LaskaKit/ESPink-Frame-7x/Version.md

### Version 1.2
- added test pads
- SPECTRA driver changes:
    - C20: 4.7uF -> 10uF
    - C13: 4.7uF -> 10uF
    - C47: 47uF -> 100uF 
    - R35: 0.24 ohm -> 0.1ohm
    - Q4: Si1308EDL -> AO3400A
#### Version 1.1
- Spectra connector mirrored
- Window for WiFi antenna
- Display jumper added
#### Version 1.0
- Initial | Počáteční
