LaskaKit/ESPink-Frame-7x/img/LaskaKit-espink-frame-7-x-e-paper-board-5.jpg

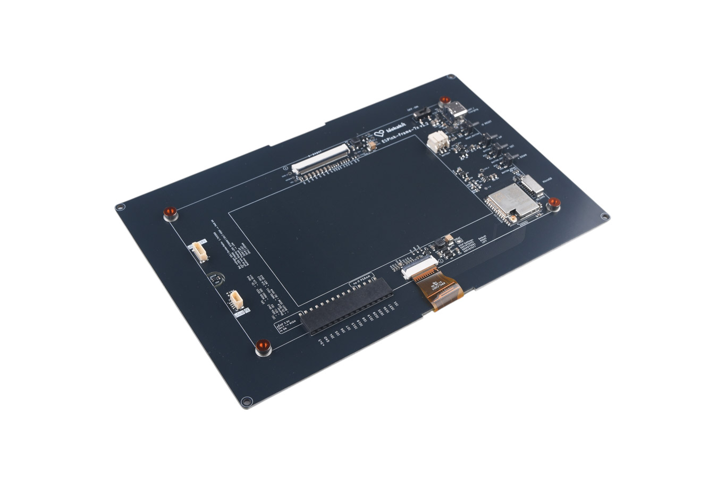
img/LaskaKit-espink-frame-7-x-e-paper-board-5.jpg
