LaskaKit/ESPink-Frame-7x/img/laskakit-live-7-x-pro-e-paper-stavebnice-s-wifi-pro---zivy-obraz-5.jpg

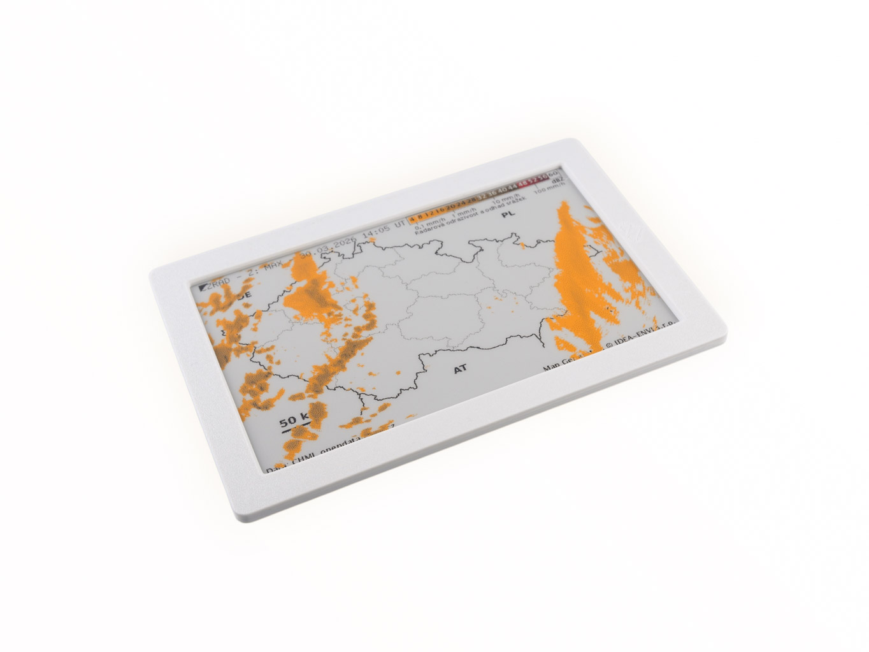
img/laskakit-live-7-x-pro-e-paper-stavebnice-s-wifi-pro---zivy-obraz-5.jpg
