LaskaKit/ESPink-Frame-7x/3D/all_live-75-pro.3mf

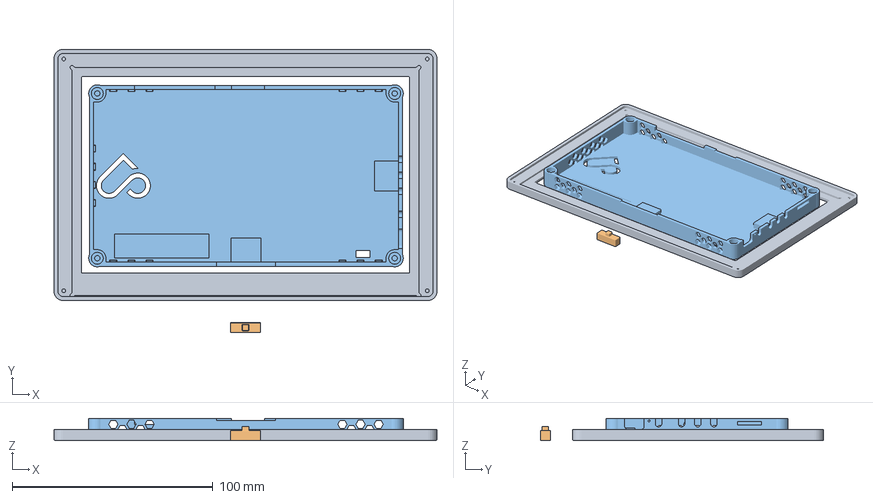
[picture p17: CAD file, 2026-03-31, last stored version]
3D/all_live-75-pro.3mf
190.6 x 141.0 x 11.0 mm
Printed_face v6
Switch v5
back v49
