LaskaKit/ESPink-Frame-7x/HW/ESPink-Frame-7x_v1_2.pdf

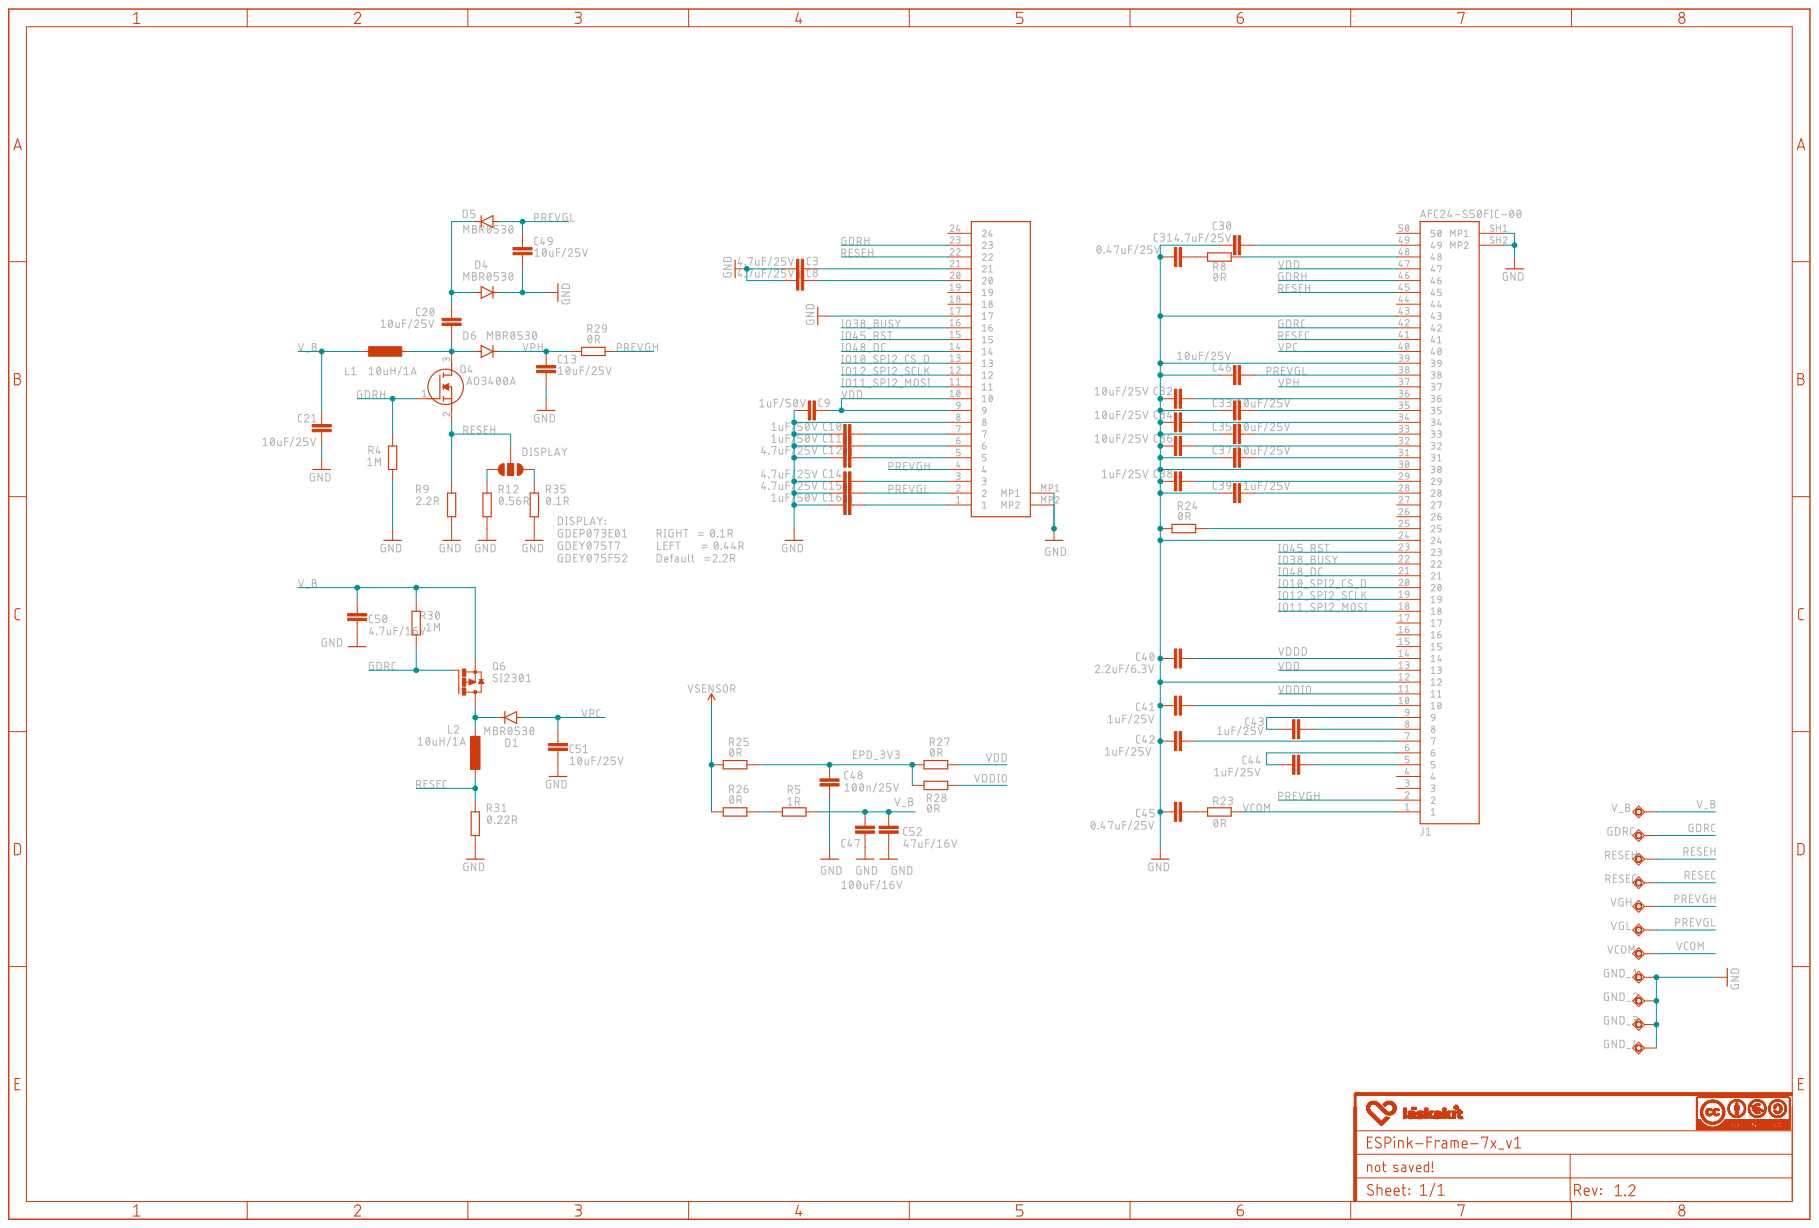
[picture p18: page 1]

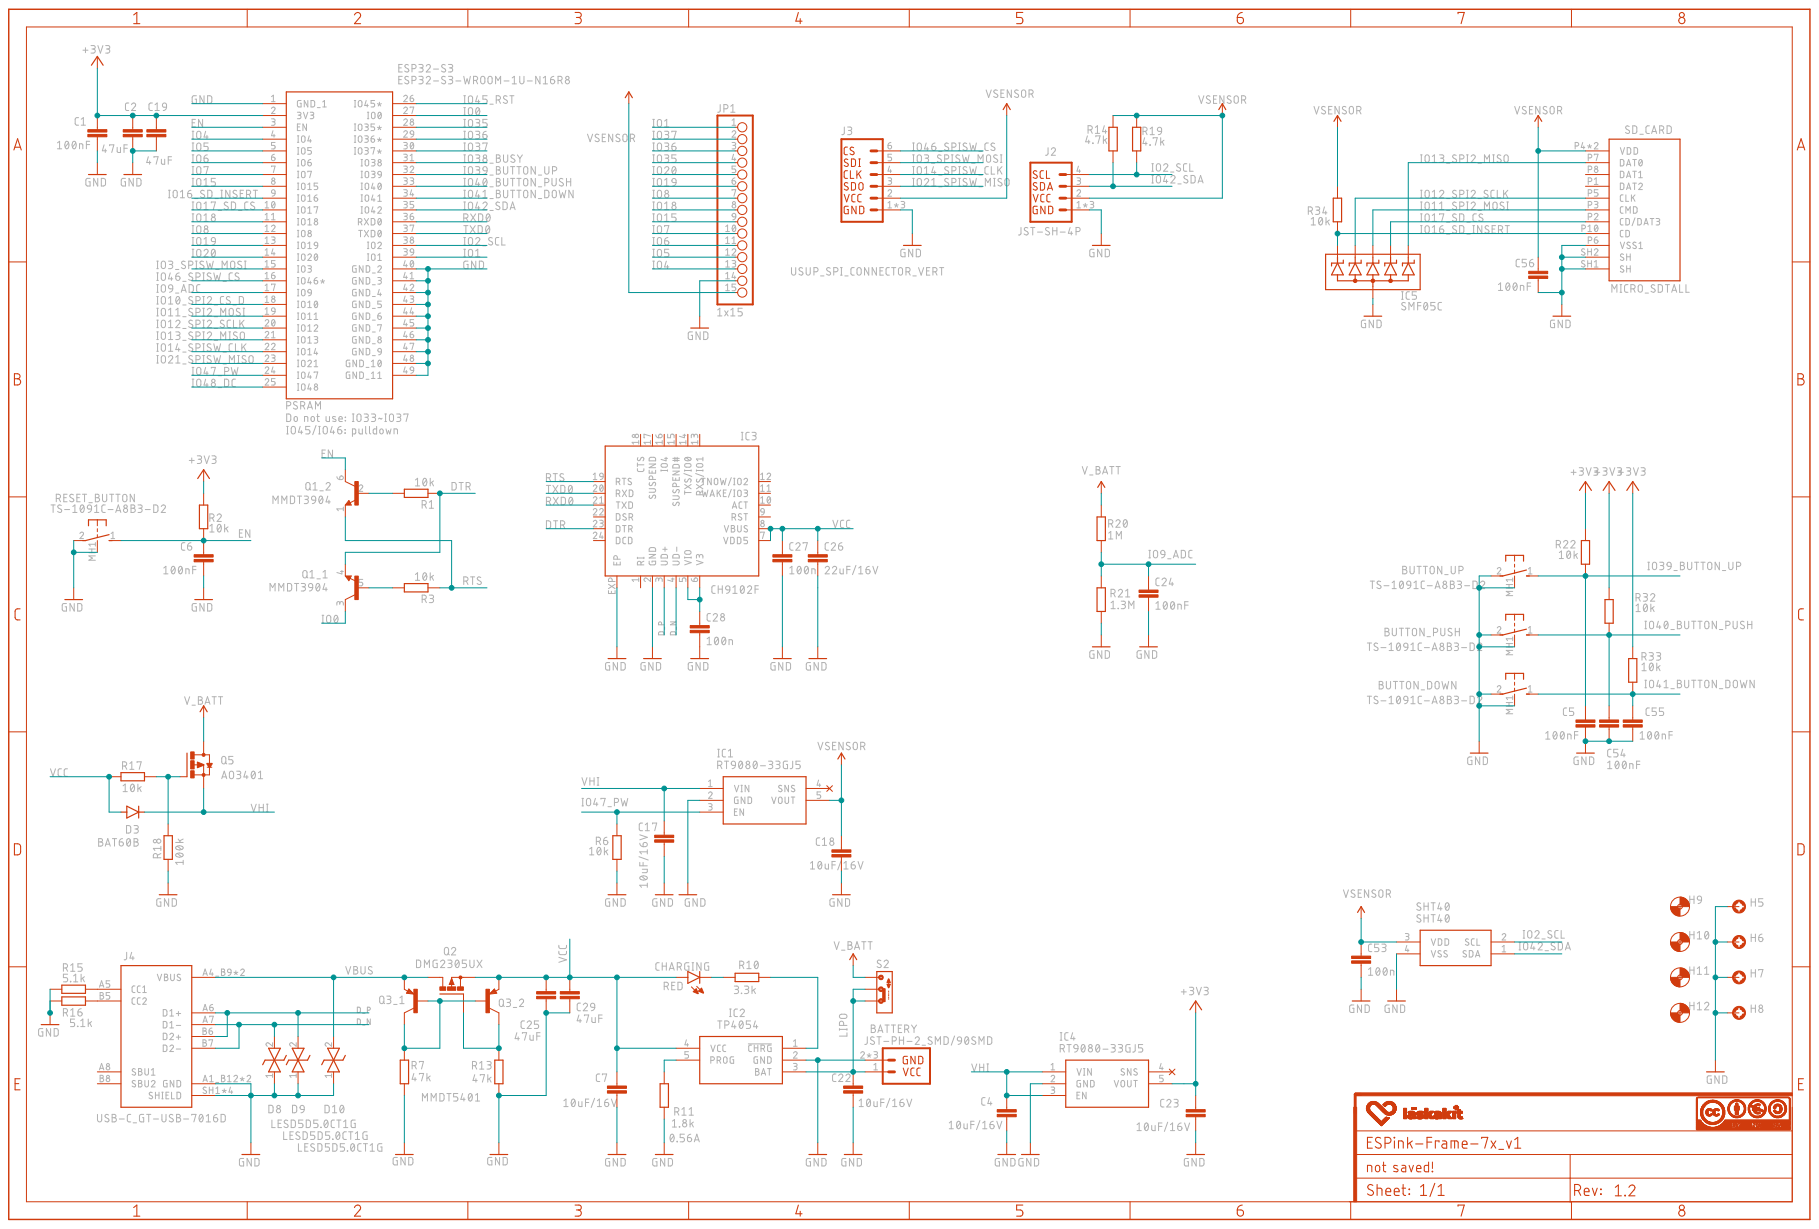
[picture p19: page 2]
