LaskaKit/ESPink-Frame-7x/HW/ESPink-Frame-7x_v1.pdf

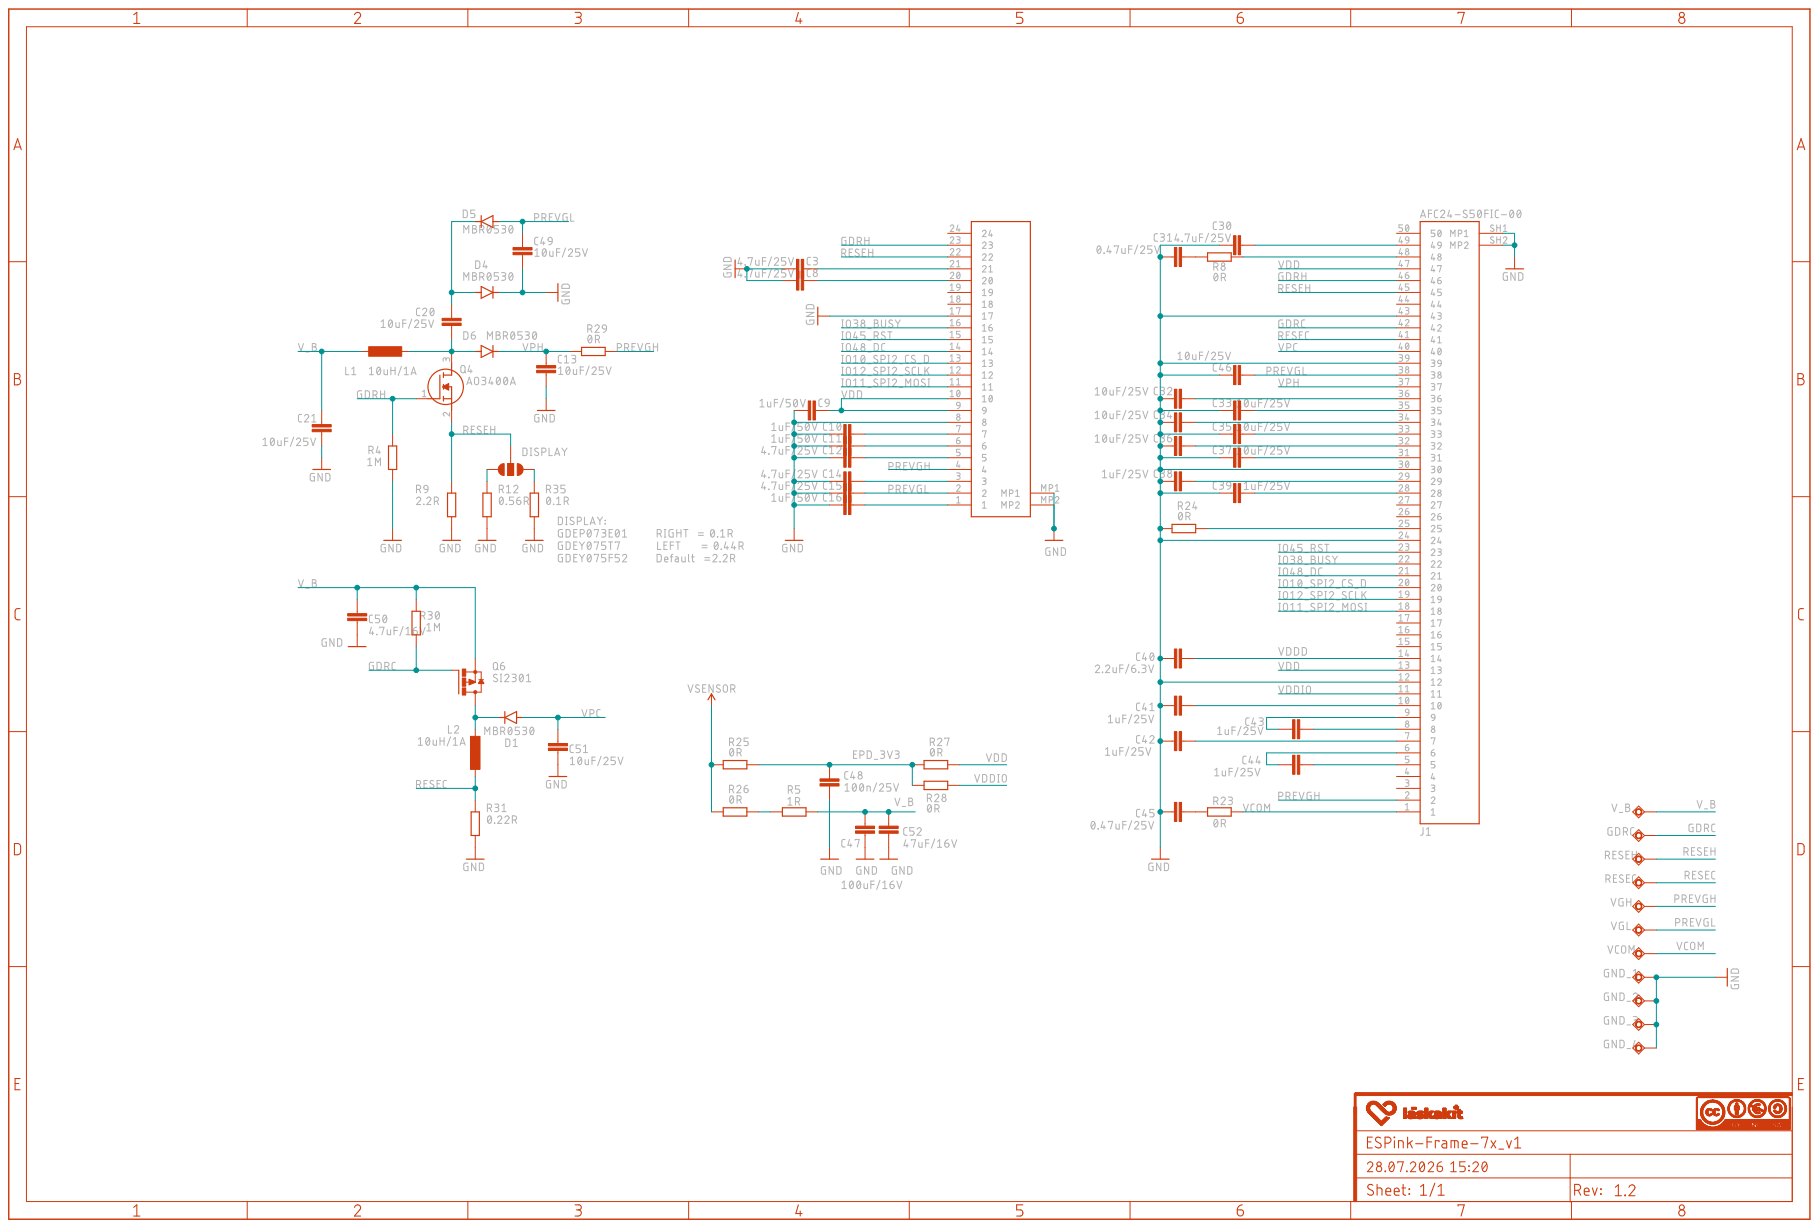
[picture p20: page 1]

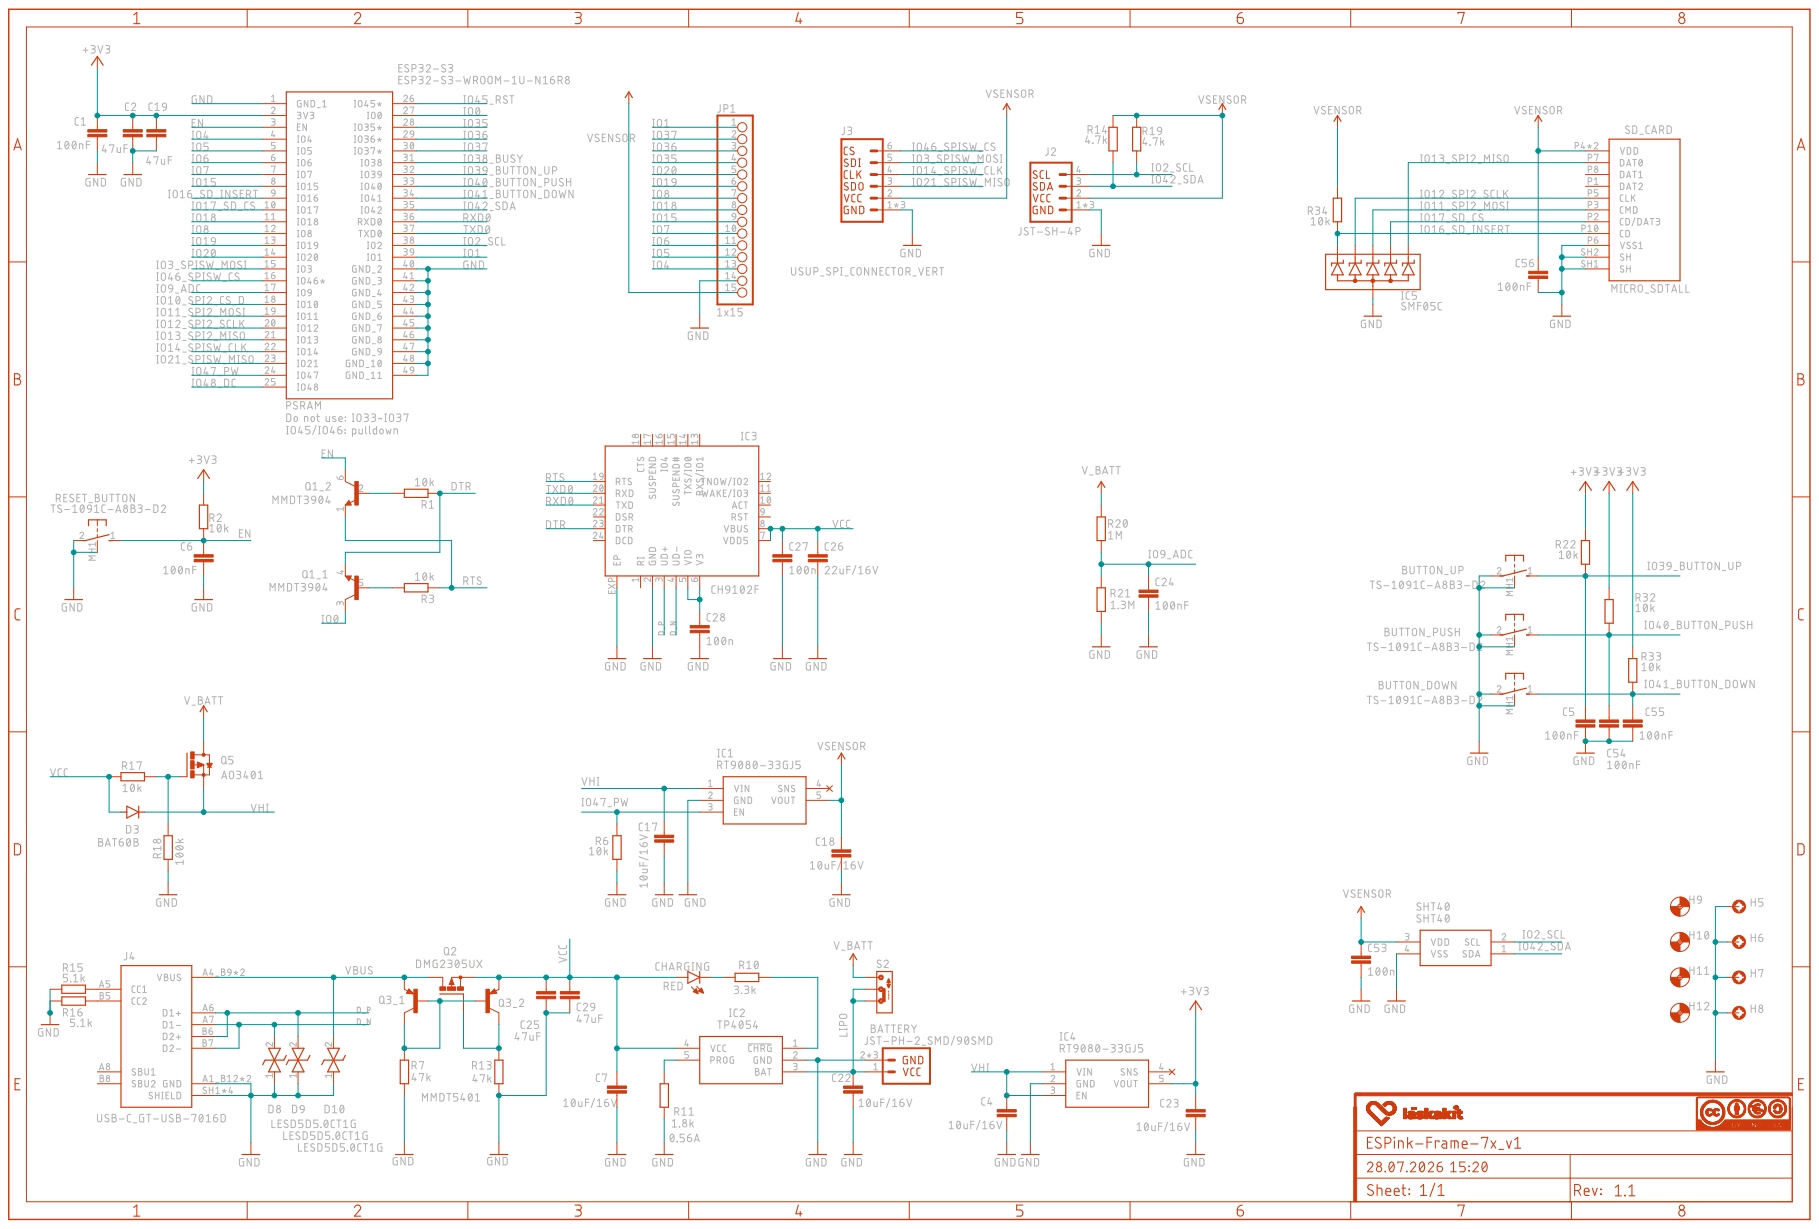
[picture p21: page 2]
