LaskaKit/ESPink-Frame-7x/(commit log)

2026-04-15 new data
    [ESPink-Frame-7x_v1 v109_bom.csv, ESPink-Frame-7x_v1_JLCPCB_BOM.csv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]
2026-05-22 moved to https://github.com/LaskaKit/Live/tree/main/7.5-pro
    [all_live-75-pro.3mf]
2026-10-09 board photo
